SchrodingersGat/reverse-geocachr/PCB/USB_Geocache.kicad_pcb

## KiCad design PCB/USB_Geocache.kicad_pcb (2018-10-09)

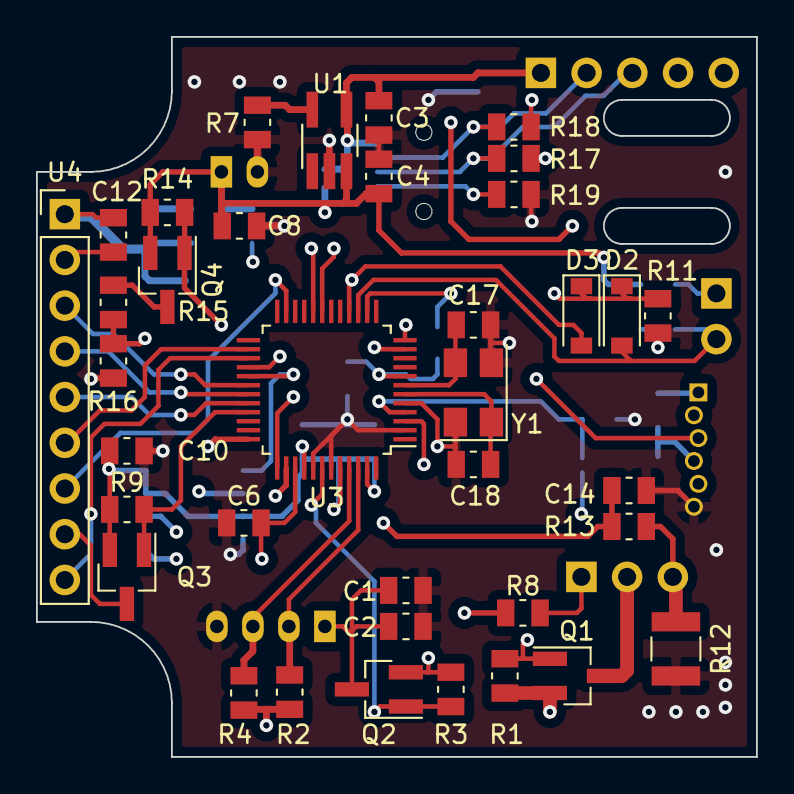
[picture p1: board USB_Geocache.kicad_pcb from above]

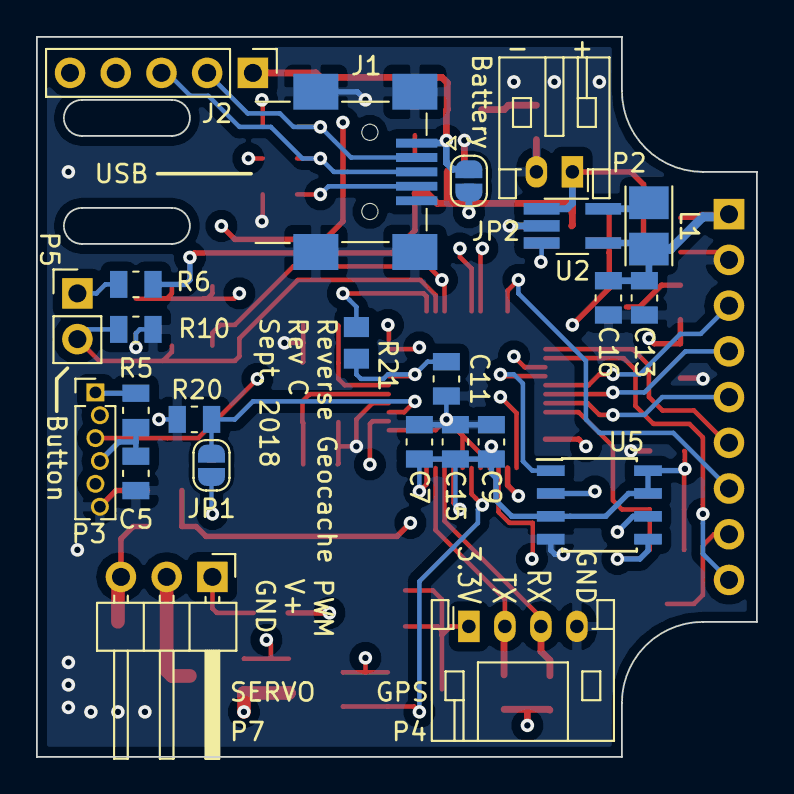
[picture p2: board USB_Geocache.kicad_pcb from below]

Board: 4 copper layers, 40.0 x 40.0 mm, 61 parts (24 on the bottom side), 39 nets.

Parts:
C1, C5, C7, C8, C9, C10, C11, C15, C16: 0.1uF; C_0805_2012Metric
C2, C6, C12, C13, C14: 10uF; C_0805_2012Metric
C3, C4: 4.7uF; C_0805_2012Metric
C17, C18: 18pF; C_0805_2012Metric
D2, D3: D; D_SOD-123
J1: USB_B_Mini; USB_Mini-B_Lumber_2486_Horizontal
J2: USB_ALT; PinHeader_1x05_P2.54mm_Vertical
JP1: Boot; SolderJumper-2_P1.3mm_Open_RoundedPad1.0x1.5mm
JP2: 5V; SolderJumper-2_P1.3mm_Open_RoundedPad1.0x1.5mm
L1: 10uH; L_Taiyo-Yuden_NR-24xx_HandSoldering
P2: Battery; JST_PH_S2B-PH-K_1x02_P2.00mm_Horizontal
P3: SWD; PinHeader_1x06_P1.27mm_Vertical
P4: GPS; JST_PH_S4B-PH-K_1x04_P2.00mm_Horizontal
P5: Button; PinHeader_1x02_P2.54mm_Vertical
P7: Servo; PinHeader_1x03_P2.54mm_Horizontal
Q1, Q2, Q3, Q4: DMP3099L; SOT-23_Handsoldering
R1, R3, R5, R6, R7, R8, R9, R11, R13, R14, R15: 4K7; R_0805_2012Metric
R2, R4, R10, R16, R20, R21: 10K; R_0805_2012Metric
R12: 0R1; R_1210_3225Metric
R17, R18: 0; R_0805_2012Metric
R19: 100K; R_0805_2012Metric
U1: MCP73831-2-OT; TSOT-23-5_HandSoldering
U2: LM3670MF; TSOT-23-5_HandSoldering
U3: LPC11U68JBD48E; LQFP-48_7x7mm_P0.5mm
U4: CR2013-MI2120; PinHeader_1x09_P2.54mm_Vertical
U5: 25LC640A-I/SN; SOIC-8_3.9x4.9mm_P1.27mm
Y1: 8MHz; Crystal_SMD_5032-4Pin_5.0x3.2mm

Connections:
+3V3: C7.1, C9.1, C10.2, C11.1, C12.1, C13.1, C15.1, C16.1, JP1.1, L1.1, P3.1, Q2.2, Q3.2, R2.1, R3.1, R4.1, R5.1, R8.1, R9.1, R21.1, U2.4, U3.8, U3.40, U3.44, U3.47, U4.1, U5.3, U5.7, U5.8
+5V: C3.1, J1.1, J2.1, JP2.1, U1.4
+BATT: C4.1, C8.1, JP2.2, P2.1, Q1.2, Q4.2, R1.2, R6.1, R14.1, U1.3, U2.1
/BUTTON: D2.2, P5.2, R10.1, U3.15
/CS_EEPROM: U3.29, U5.1
/EN: D2.1, D3.1, R11.1, U2.3
/GPS_PWR: Q2.1, R3.2, U3.42
/GPS_RX: P4.3, R4.2, U3.45
/GPS_TX: P4.2, R2.2, U3.46
/I_SERVO: C14.1, R13.1, U3.38
/LDC_BL: Q3.1, R9.2, U3.33
/OSC1: C18.1, U3.6, Y1.1
/OSC2: C17.1, U3.7, Y1.3
/SERVO_EN: Q1.1, R1.1, U3.11
/SERVO_PWM: P7.1, R8.2, U3.12
/SPI_MISO: U3.27, U4.9, U5.2
/SPI_MOSI: U3.26, U4.6, U5.5
/SPI_SCK: U3.23, U4.7, U5.6
/SWCLK: P3.3, U3.28
/SWDIO: P3.2, U3.37
/SW_ENABLE: D3.2, U3.16
/SW_RESET: C5.1, P3.4, R5.2, U3.3
/USB_D+: R17.1, U3.20
/USB_D-: R18.1, U3.19
/VMEAS_CTRL: Q4.1, R14.2, U3.36
/V_BATT: C6.1, R15.2, R16.1, U3.39
GND: C1.2, C2.2, C3.2, C4.2, C5.2, C6.2, C7.2, C8.2, C9.2, C10.1, C11.2, C12.2, C13.2, C14.2, C15.2, C16.2, C17.2, C18.2, J1.5, J1.6, J2.5, P2.2, P3.6, P4.4, R7.2, R10.2, R11.2, R12.2, R16.2, R19.2, R20.2, U1.2, U2.2, U3.2, U3.5, U3.41, U3.43, U4.2, U5.4, Y1.2, Y1.4
unnamed: C1.1, C2.1, P4.1, Q2.3
unnamed: J1.2, J2.2, R18.2
unnamed: J1.3, J2.3, R17.2
unnamed: J1.4, J2.4, R19.1
unnamed: JP1.2, R20.1, U3.4
unnamed: L1.2, U2.5
unnamed: P5.1, R6.2
unnamed: P7.2, Q1.3
unnamed: P7.3, R12.1, R13.2
unnamed: Q4.3, R15.1
unnamed: R7.1, U1.5
unnamed: R21.2, U3.14
