SchrodingersGat/reverse-geocachr/Code/STM32_Firmware/Inc/main.h

#define NCS_MEMS_SPI_Pin GPIO_PIN_0
#define NCS_MEMS_SPI_GPIO_Port GPIOC
#define MEMS_INT1_Pin GPIO_PIN_1
#define MEMS_INT1_GPIO_Port GPIOC
#define MEMS_INT2_Pin GPIO_PIN_2
#define MEMS_INT2_GPIO_Port GPIOC
#define B1_Pin GPIO_PIN_0
#define B1_GPIO_Port GPIOA
#define EXT_RESET_Pin GPIO_PIN_5
#define EXT_RESET_GPIO_Port GPIOC
#define LD3_Pin GPIO_PIN_6
#define LD3_GPIO_Port GPIOC
#define LD6_Pin GPIO_PIN_7
#define LD6_GPIO_Port GPIOC
#define LD4_Pin GPIO_PIN_8
#define LD4_GPIO_Port GPIOC
#define LD5_Pin GPIO_PIN_9
#define LD5_GPIO_Port GPIOC
#define USBF4_DM_Pin GPIO_PIN_11
#define USBF4_DM_GPIO_Port GPIOA
#define USBF4_DP_Pin GPIO_PIN_12
#define USBF4_DP_GPIO_Port GPIOA
#define SWDIO_Pin GPIO_PIN_13
#define SWDIO_GPIO_Port GPIOA
#define SWCLK_Pin GPIO_PIN_14
#define SWCLK_GPIO_Port GPIOA
#define LCD_CS_Pin GPIO_PIN_3
#define LCD_CS_GPIO_Port GPIOB
#define LCD_DC_Pin GPIO_PIN_6
#define LCD_DC_GPIO_Port GPIOB
#define LCD_RESET_Pin GPIO_PIN_7
#define LCD_RESET_GPIO_Port GPIOB
