SchrodingersGat/reverse-geocachr/Code/STM32_Firmware/Src/main.c

/**
  ******************************************************************************
  * File Name          : main.c
  * Description        : Main program body
  ******************************************************************************
  *
  * Copyright (c) 2018 STMicroelectronics International N.V. 
  * All rights reserved.
  *
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
  ******************************************************************************
  */
/* Includes ------------------------------------------------------------------*/
#include "main.h"
#include "stm32f0xx_hal.h"
#include "spi.h"
#include "tim.h"
#include "usart.h"
#include "usb_device.h"
#include "gpio.h"

/* USER CODE BEGIN Includes */
#include "display.h"
#include "ILI9340.h"
#include "types.h"
#include "timer.h"
/* USER CODE END Includes */


/* USER CODE BEGIN PV */
BoxStatus_t status;
BoxSettings_t settings;
BoxVersion_t version;
GPSData_t gps;
Timers_t timers;
/* USER CODE END PV */

void SystemClock_Config(void);
void Error_Handler(void);

/* USER CODE BEGIN PFP */

/* USER CODE END PFP */

/* USER CODE BEGIN 0 */

/**
 * Update the box state machine
 */
void SetState(uint8_t state)
{
	if (state == status.state)
		return;

	status.state = state;
	timers.stateTimer = 0;
}
/* USER CODE END 0 */

int main(void)
{

  /* MCU Configuration----------------------------------------------------------*/

  /* Reset of all peripherals, Initializes the Flash interface and the Systick. */
  HAL_Init();

  /* Configure the system clock */
  SystemClock_Config();

  /* Initialize all configured peripherals */
  MX_GPIO_Init();
  MX_SPI1_Init();
  MX_USART1_UART_Init();
  MX_USB_DEVICE_Init();
  MX_TIM1_Init();

  /* USER CODE BEGIN 2 */
	SetState(STATE_POWERON);
	ILI9340_Reset_Low();
	PauseMs(50);
	LCD_Initialize();

	ILI9340_FillScreen(RED);
	ILI9340_FillScreen(GREEN);
	ILI9340_FillScreen(BLUE);

  /* USER CODE END 2 */

  /* Infinite loop */
  /* USER CODE BEGIN WHILE */
  while (1)
  {
  /* USER CODE END WHILE */

  /* USER CODE BEGIN 3 */

		/* All events are handled asynchronously.
		 * All we have to here is update the display
		 */

		/*
		 * Check for new GPS reading
		 * 1. Turn off UART Rx interrupt
		 * 2. Copy GPS data (if there is a new reading)
		 * 3. Turn UART Rx interrupts back on
		 */

		  HAL_GPIO_TogglePin(LD5_GPIO_Port, LD5_Pin);

		__HAL_UART_DISABLE_IT(&huart1, UART_IT_RXNE);

		if (GPS_CopyData(&gps))
		{
			status.gpsStatus = gps.pfi;
			status.gpsConnection = 1;
		}

		__HAL_UART_ENABLE_IT(&huart1, UART_IT_RXNE);

		// Update main state machine
		switch (status.state)
		{
		// Progress between GPS acquisition states
		case STATE_POWERON:
			if (timers.stateTimer > 3)
			{
				SetState(STATE_GPS_ACQUIRING);
			}
			break;
		case STATE_GPS_ACQUIRING:
		case STATE_GPS_LOCKING:
			// GPS is connected
			if (status.gpsConnection)
			{
				// No lock for 5 minutes
				if (timers.gpsNoLock > TIMEOUT_NO_GPS_LOCK)
				{
					SetState(STATE_GPS_NO_LOCK);
				}
				else
				{
					switch (status.gpsStatus)
					{
					case 0: // No lock yet
						SetState(STATE_GPS_ACQUIRING);
						break;
					case 1:
						SetState(STATE_GPS_LOCKING);
						break;
					case 2:
					case 3:
						SetState(STATE_GPS_LOCKED);
						break;
					default:
						SetState(STATE_GPS_ERROR);
						break;
					}
				}
			}

			if (timers.gpsNoRx > TIMEOUT_NO_GPS_DATA)
			{
				SetState(STATE_GPS_NO_DATA);
			}
			break;
		case STATE_GPS_LOCKED:
			if (timers.stateTimer > 1) // Two seconds
			{
				//TODO - Check distance to current waypoint here
				SetState(STATE_TOO_FAR);
			}
			break;
		}

		LCD_Update();

		PauseMs(50);
  }
  /* USER CODE END 3 */

}

/** System Clock Configuration
*/
void SystemClock_Config(void)
{

  RCC_OscInitTypeDef RCC_OscInitStruct;
  RCC_ClkInitTypeDef RCC_ClkInitStruct;
  RCC_PeriphCLKInitTypeDef PeriphClkInit;

    /**Initializes the CPU, AHB and APB busses clocks 
    */
  RCC_OscInitStruct.OscillatorType = RCC_OSCILLATORTYPE_HSI48;
  RCC_OscInitStruct.HSIState = RCC_HSI_ON;
  RCC_OscInitStruct.HSI48State = RCC_HSI48_ON;
  RCC_OscInitStruct.PLL.PLLState = RCC_PLL_ON;
  RCC_OscInitStruct.PLL.PLLSource = RCC_PLLSOURCE_HSI48;
  RCC_OscInitStruct.PLL.PLLMUL = RCC_PLL_MUL3;
  RCC_OscInitStruct.PLL.PREDIV = RCC_PREDIV_DIV4;
  if (HAL_RCC_OscConfig(&RCC_OscInitStruct) != HAL_OK)
  {
    Error_Handler();
  }

    /**Initializes the CPU, AHB and APB busses clocks 
    */
  RCC_ClkInitStruct.ClockType = RCC_CLOCKTYPE_HCLK|RCC_CLOCKTYPE_SYSCLK
                              |RCC_CLOCKTYPE_PCLK1;
  RCC_ClkInitStruct.SYSCLKSource = RCC_SYSCLKSOURCE_PLLCLK;
  RCC_ClkInitStruct.AHBCLKDivider = RCC_SYSCLK_DIV1;
  RCC_ClkInitStruct.APB1CLKDivider = RCC_HCLK_DIV1;

  if (HAL_RCC_ClockConfig(&RCC_ClkInitStruct, FLASH_LATENCY_1) != HAL_OK)
  {
    Error_Handler();
  }

  PeriphClkInit.PeriphClockSelection = RCC_PERIPHCLK_USB|RCC_PERIPHCLK_USART1;
  PeriphClkInit.Usart1ClockSelection = RCC_USART1CLKSOURCE_PCLK1;
  PeriphClkInit.UsbClockSelection = RCC_USBCLKSOURCE_HSI48;

  if (HAL_RCCEx_PeriphCLKConfig(&PeriphClkInit) != HAL_OK)
  {
    Error_Handler();
  }

    /**Configure the Systick interrupt time 
    */
  HAL_SYSTICK_Config(HAL_RCC_GetHCLKFreq()/1000);

    /**Configure the Systick 
    */
  HAL_SYSTICK_CLKSourceConfig(SYSTICK_CLKSOURCE_HCLK);

  /* SysTick_IRQn interrupt configuration */
  HAL_NVIC_SetPriority(SysTick_IRQn, 0, 0);
}

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
