SchrodingersGat/reverse-geocachr/Code/LPC11U68_Firmware/inc/box_usb.h

/*
 * box_usb.h
 *
 *  Created on: Jun 19, 2018
 *      Author: Oliver
 */

#ifndef INC_BOX_USB_H_
#define INC_BOX_USB_H_

#include <stdbool.h>
#include <stdint.h>

#include "box_defines.h"

#define BUF_SIZE 64

// Data buffers
extern HIDBuffer txBuf;
extern HIDBuffer rxBuf;

bool Box_DecodeMessage();

#endif /* INC_BOX_USB_H_ */
