SchrodingersGat/reverse-geocachr/(commit log)

2016-01-28 Added waypoint distance calculation Fixes to a lot of GUI features (getting close to fully functional again)
    [lcdwidget.cpp, mainwindow.cpp, mainwindow.h, ui_mainwindow.h]
2016-01-29 Committed PCB files (work still to be done here)
    [USB_Geocache.csv, USB_Geocache.kicad_pcb, USB_Geocache.sch, USB_Geocache_BOM.csv]
2016-01-29 GUI - proper indication of currently selected clue in google-map window
2016-01-30 Correctly reading the box info and can skip back/forward clues
    [boxinterface.cpp, mainwindow.cpp, ui_mainwindow.h]
2016-01-30 GUI can now write clue text to the device
2016-02-09 Initial PCB layout
    [USB_Geocache.kicad_pcb, USB_Geocache.sch]
2016-02-09 Fixes to schematic
    [USB_Geocache.kicad_pcb, USB_Geocache.sch]
2016-02-11 Released revision B of PCB
    [USB_Geocache.kicad_pcb, USB_Geocache.sch]
2016-03-08 Fixes to PCB
    [USB_Geocache.csv, USB_Geocache.kicad_pcb, USB_Geocache.sch]
2016-03-29 Fixes to schematic and PCB layout
    [USB_Geocache.kicad_pcb, USB_Geocache.sch]
2016-04-02 Added current sense for the servo Added LED backlight FET for the LCD PCB improvements
    [USB_Geocache.kicad_pcb, USB_Geocache.sch]
2016-04-02 Silkscreen improvements
    [USB_Geocache.kicad_pcb, USB_Geocache.sch]
2016-04-03 Fixed firmware to work with protogen packet structure
    [box_usb.c, box_usb.h]
2016-04-03 Fixed GUI so that it works with new protogen packets
    [boxinterface.cpp, boxinterface.h, lcdwidget.cpp, mainwindow.cpp, ui_mainwindow.h, waypoints.cpp, waypoints.h]
2016-04-03 Fixes to glue packets
    [display.c]
2016-04-05 Changed resistor value
    [USB_Geocache.sch]
2016-06-11 Systick timer working Backlight ON/OFF working PauseMs working
2016-06-11 Added bootload command to UI Added button to clear all clue text
2016-06-20 Commented out reenter-isp code (works, kinda. weird error)
    [hid_main.c]
2016-06-28 Still can't figure out the SPI errors...
    [hid_main.c, spi.c]
2016-09-29 SPI is now working
2017-05-03 Rearranging firmware
    ( New STM32 code )
2017-05-03 PCB updates
    [USB_Geocache.csv, USB_Geocache.kicad_pcb, USB_Geocache.sch]
2017-07-23 UART rx is working
    Skeleton for GPS parsing
2018-03-04 Updated schematics for STM32F072
    * No crystal required for USB
    * Higher SPI speed (18MHz)
    * Simplified some circuits
    * Fixed current draw issues (e.g. for Vmeas resistor divider)
    [USB_Geocache-2018-03-02-10-15-33.sch, USB_Geocache-2018-03-03-19-34-42.sch, USB_Geocache.kicad_pcb, USB_Geocache.sch]
2018-03-10 UART GPS decoding now working
    This took some work to understand:
    a) Converting DDMM.MMMM format to decimal degrees
    b) Enable floating point support for sscanf with linker flag "-u scanf_float"
2018-03-10 Fixed math linker issue
    - Unlink "c math" library to enable sqrt to work
    [display.c, display.h, gps.c]
2018-03-11 Added reception indicator and improved state machine
    - Added bar display to top-left corner
    - Improved state machine logic with SetState function
    - Added state timer
2018-03-11 Improve GPS error reporting
    [main.c]
2018-03-19 PCB Layout
    - Completed PCB layout for new processor (Rev C)
    [USB_Geocache.kicad_pcb, USB_Geocache.sch]
2018-03-19 Further PCB tweaks
    [USB_Geocache.kicad_pcb, USB_Geocache.sch]
2018-06-17 Using the STM32F072 discovery board
    [USB_Geocache.sch]
2018-06-17 Fixed SPI parameters
2018-06-18 Added skeleton for LPC firmware
    - Yep, going back to the LPC
    - USB HID is MUCH simpler to use!
    - Faster SPI (up to 25Mbit on some units)
    - Internal EEPROM (enough to store box state)
    - Waypoints can be written to FLASH
2018-07-31 More work on FLASH programming
    - Read clues from FLASH
    - Erase FLASH and write entire set of clues
    [USB_Geocache.kicad_pcb]
2018-08-09 Fixes for GUI comms
    - Mutex lock a bunch of stuff
    - Ability to write box settings
    [boxinterface.cpp, boxinterface.h, lcdwidget.cpp, mainwindow.cpp, mainwindow.h, ui_mainwindow.h, waypoints.cpp, waypoints.h]
2018-08-11 Major UI code improvements
    - Mutex locked transmit() and receive() functions now control everything
    - Code much simpler
    - Comms routines are much quicker and more stable
    - Bug fixes too
    - Better code debugging
    [boxinterface.cpp, boxinterface.h, waypoints.cpp]
2018-08-11 Bug fixes for USB decoding on LPC side
    - Decode request packets second (due to zero-length packet requirement)
    - Bug fix for a packet decodea
    [box_usb.c]
2018-08-14 Clues now correctly written to FLASH memory
    [box_usb.c, waypoints.c]
2018-08-14 seems to have fixed the hard-fault on FLASH write
    - NOTE TO ALL - LPC SUCKS SO MUCH
    [waypoints.c]
2018-08-15 Fix welcome message loading
    [boxinterface.cpp, main.cpp, mainwindow.cpp]
2018-08-20 Configure PID and VID
2018-08-20 SysTick timer now works
2018-08-21 Looking to get SPI working
2018-08-21 Moving towards operational SPI
    - Pin mux is the worst
    - Seriously
2018-08-26 LCD now working!
    - The RESET pin was not working properly
    - Wait for SPI transactions to clear when CS pin goes low
    - SPI running at 8MHz (bottleneck is currently the delay between SPI transactions)
    [LCD_linker.c, hid_main.c, spi.c]
2018-08-26 Enable 16-bit SPI transactions for color data
    - Significant increase in refresh speed
2018-08-27 Skeleton code for GPS / UART
2018-08-27 GPS reception working fine!
    - Changed project settings to enable floating point scanf and printf
2018-08-28 Display code working (mostly)
    - GPS fixes when PFI = 1 (if HDoP < 2.5)
    [display.c, display.h, gps.c, hid_main.c, spi.c, types.h, waypoints.c, waypoints.h]
2018-08-28 Further fixes to firmware:
    - Updated flash memory addressing for new chip (flash writes now work)
    - Fix GPS calculations (include math lib)
    [display.c, eemem.c, hid_main.c, waypoints.c]
2018-10-09 PCB / BOM stuff
    [USB_Geocache.kicad_pcb, USB_Geocache.sch]
2018-11-08 Update pinout for the new PCB
    - NOTE - The MOSI and MISO pins were flipped :'(
    [LCD_linker.c, gps.c, hid_main.c, pins.h, pwm.c, spi.c]
2018-11-08 Fixed some pin errors
    - LCD_DC and LCD_RST pins were flipped (however both GPIO so OK to just switch in firmware)
    - P0.11 to P0.14 are not 'GPIO' in the default mode (fixed this)
    - SPI_CLK pin is actually FUNC_2 not FUNC_1
    - Enable .bin file generation
    [USB_Geocache.sch]
2018-11-11 Stupid LPC datasheet
    - PIO0_5 is open-drain only (buried deep in the datasheet)
    - Enable output moved to PIO1_21
    - Proper functions for turning backlight / servo / gps ON/OFF
    [USB_Geocache.sch]
2018-11-12 Added power-down message when long-pressing button
