SchrodingersGat/reverse-geocachr/(notices)

Notices in the files:
Code/STM32_Firmware/Inc/main.h:
(C) COPYRIGHT STMicroelectronics *****END OF FILE
